gsun16/ECE445/gsun16/all soldered prototype.jpg

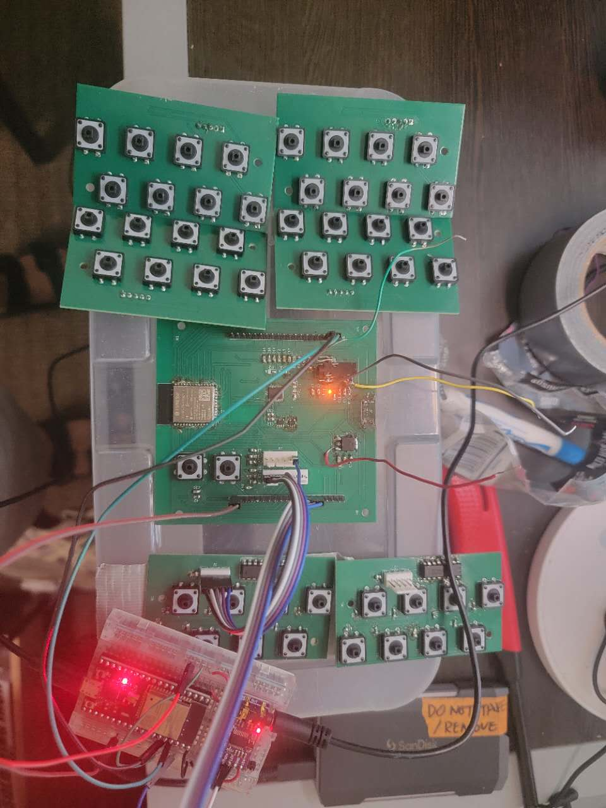
gsun16/all soldered prototype.jpg
