gsun16/ECE445/hanyu and zhuoer/Fig 4.jpg

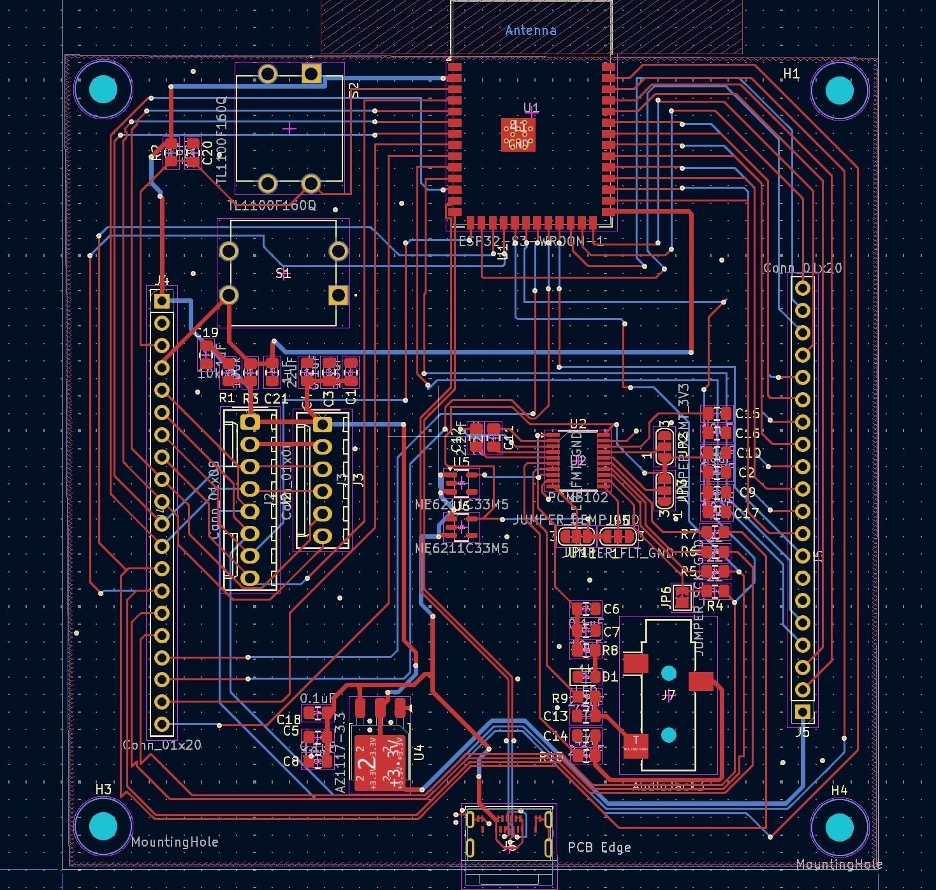
hanyu and zhuoer/Fig 4.jpg
