gsun16/ECE445/README.md

# arduino-accordion

Inspired from the project https://hackaday.io/project/197399-arduino-esp32-standalone-accordion
