gsun16/ECE445/misc/1.pptx

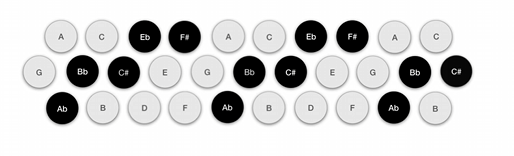
[picture p3: figure]
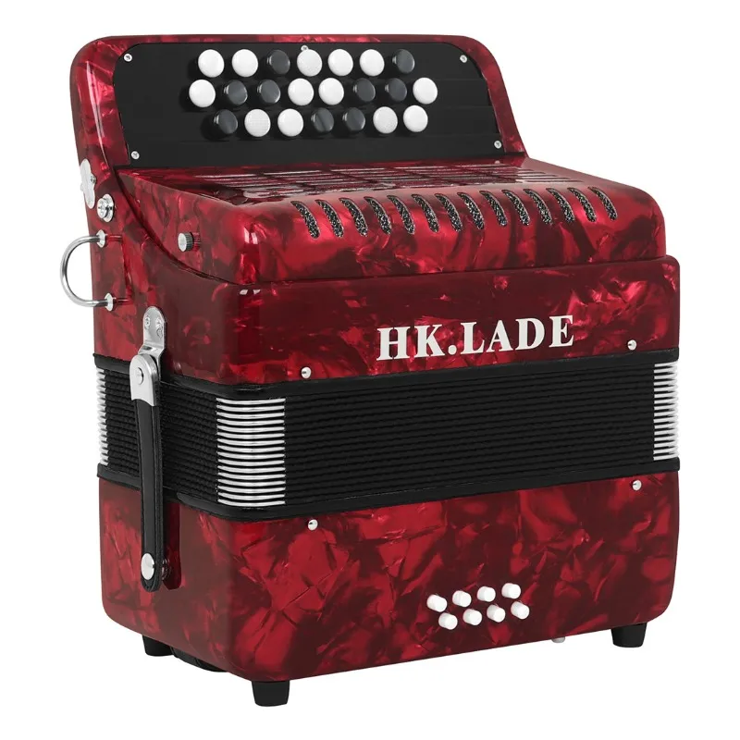
[picture p4: figure]
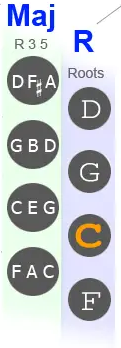
[picture p5: figure]

Treble
Key

All of the electronics will be stored in the bellow of the accordion

Bass
Button
