gsun16/ECE445/gsun16/bass layout.jpg

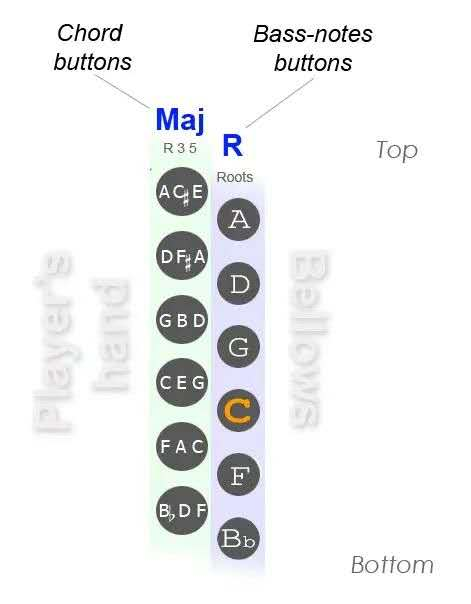
gsun16/bass layout.jpg
