gsun16/ECE445/gsun16/breadboard circuit.jpg

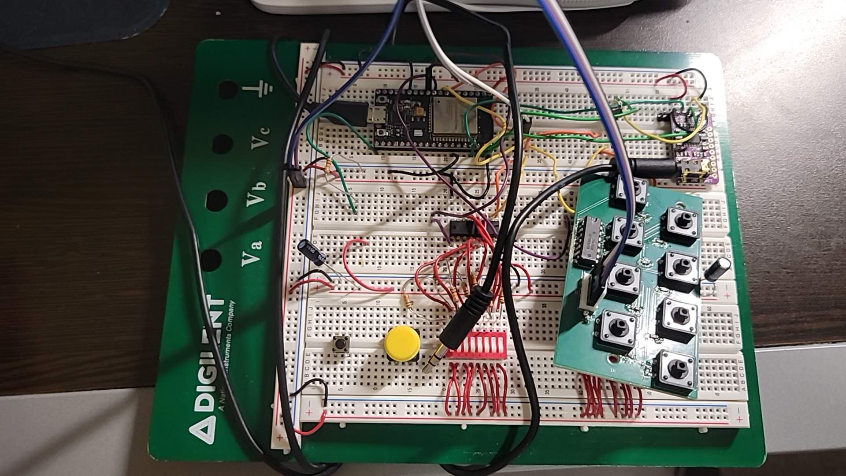
gsun16/breadboard circuit.jpg
