gsun16/ECE445/gsun16/debounce time.png

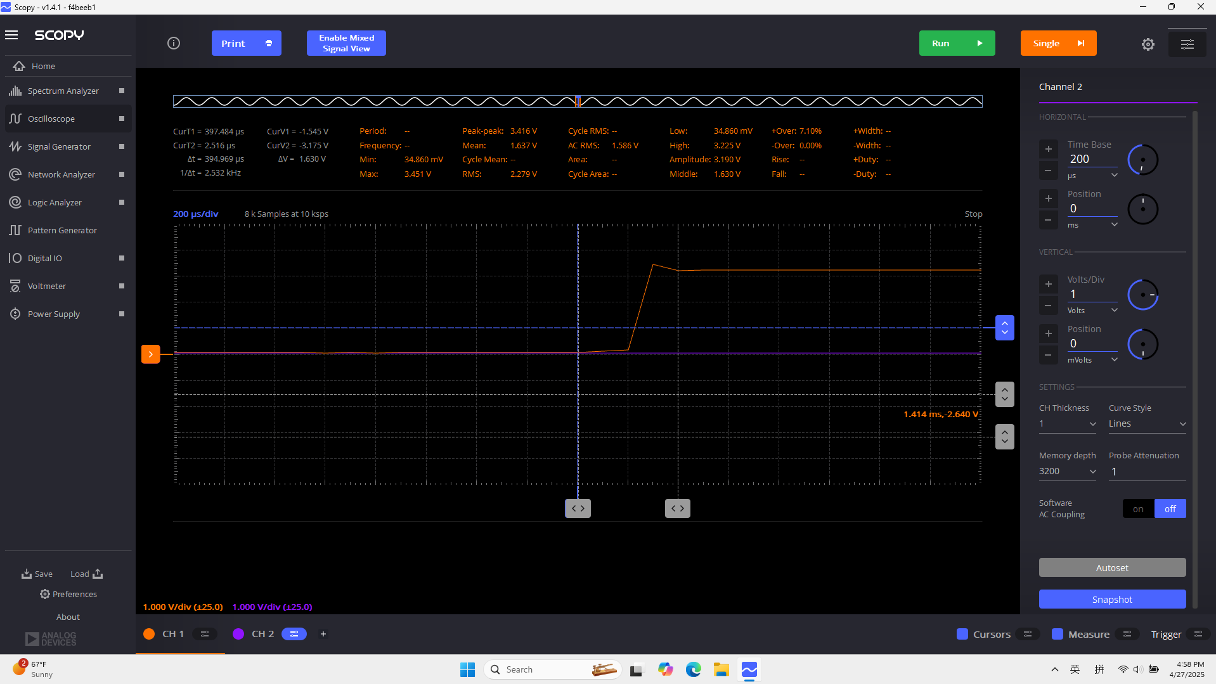
gsun16/debounce time.png
