gsun16/ECE445/gsun16/mapping draft made with hanyu.jpg

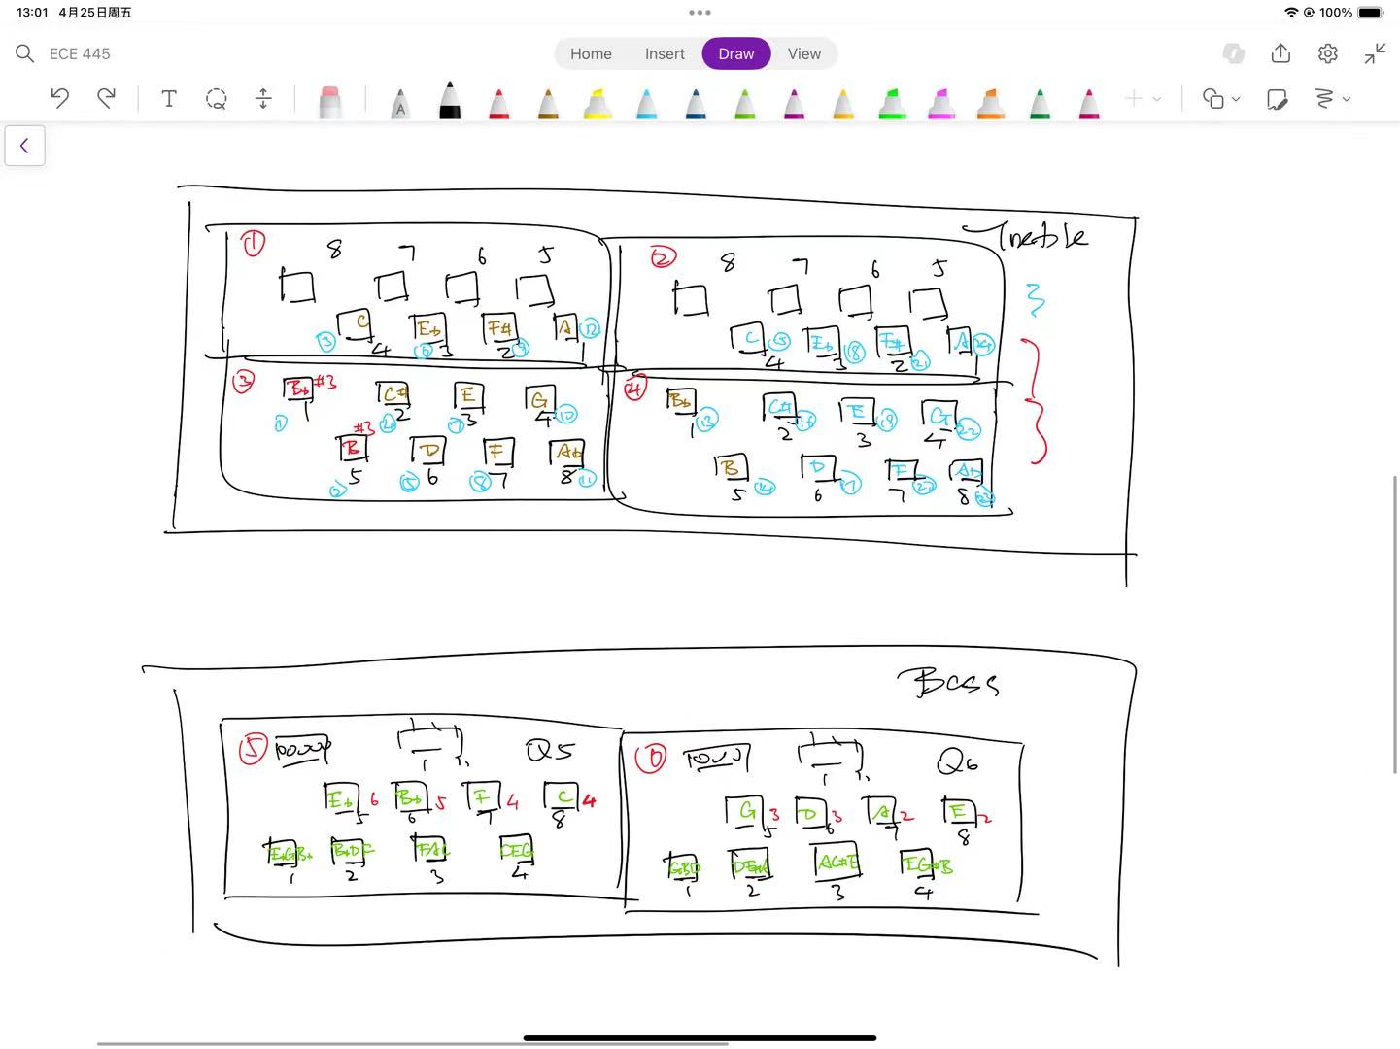
gsun16/mapping draft made with hanyu.jpg
