gsun16/ECE445/hanyu and zhuoer/Fig 1.jpg

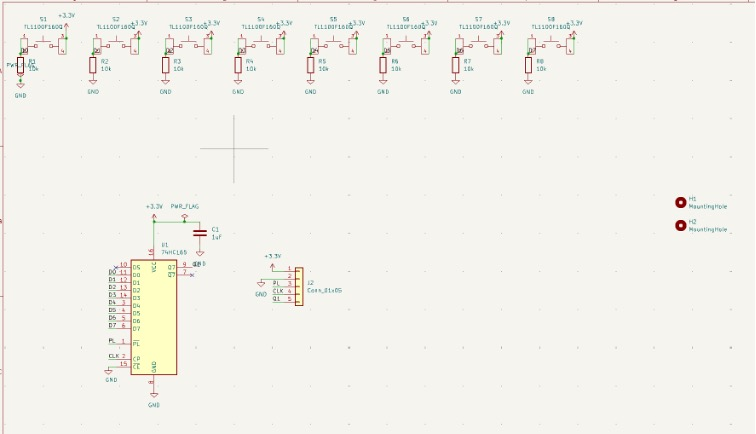
hanyu and zhuoer/Fig 1.jpg
