gsun16/ECE445/hanyu and zhuoer/Fig 2.png

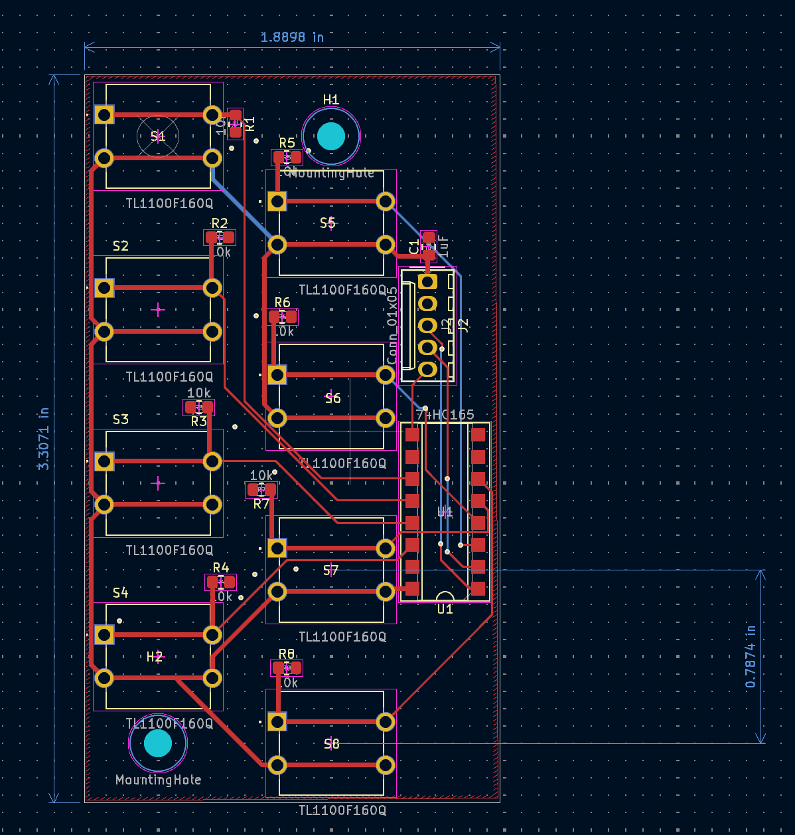
hanyu and zhuoer/Fig 2.png
