gsun16/ECE445/hanyu and zhuoer/Fig 3.jpg

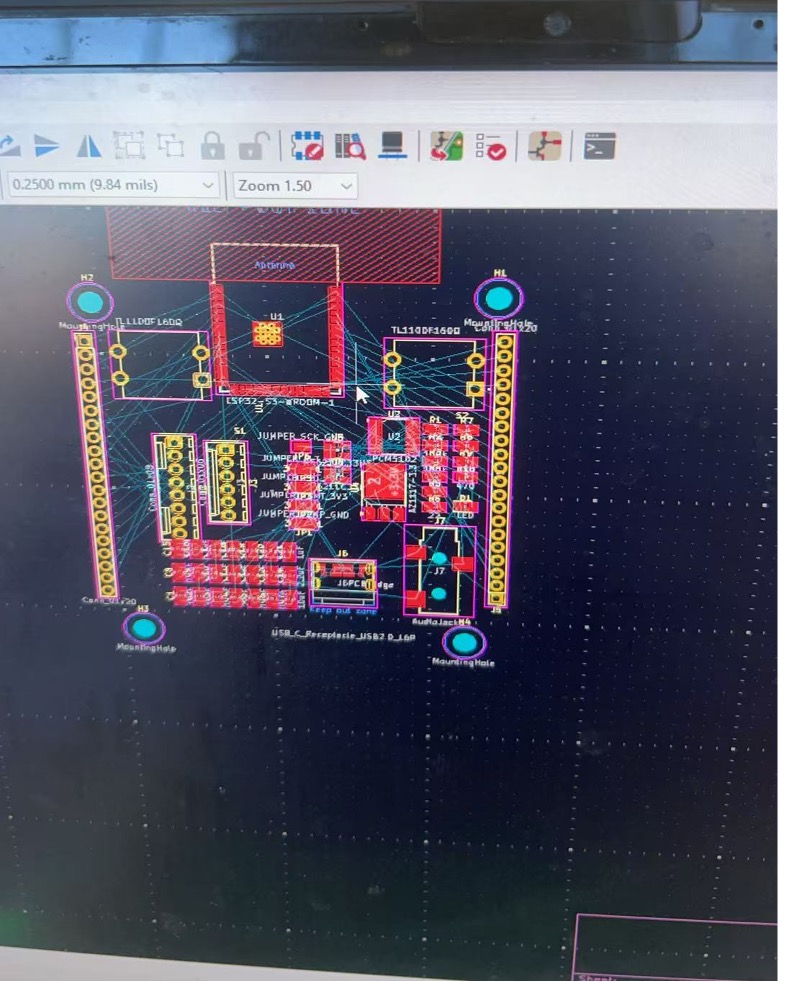
hanyu and zhuoer/Fig 3.jpg
