gsun16/ECE445/hanyu and zhuoer/Fig 5.png

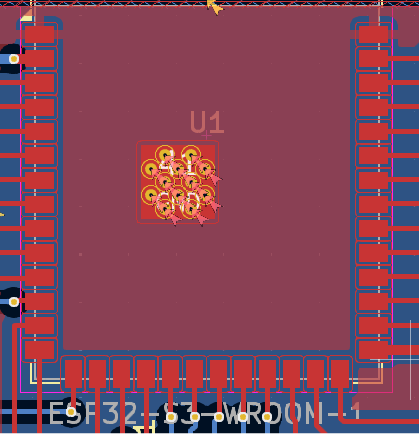
hanyu and zhuoer/Fig 5.png
