gsun16/ECE445/hanyu and zhuoer/Fig 6.jpg

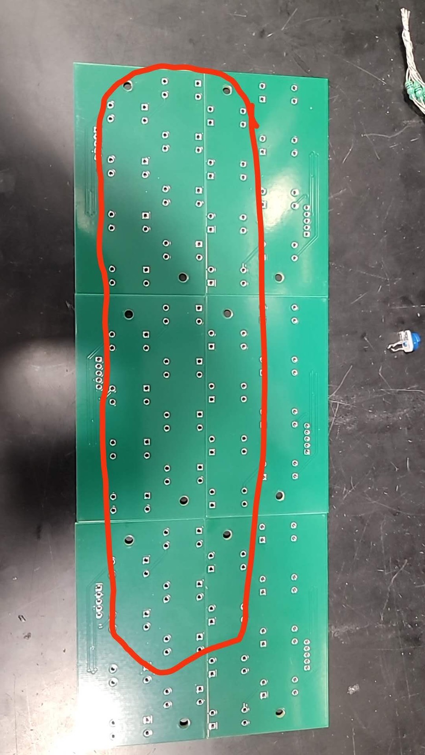
hanyu and zhuoer/Fig 6.jpg
