gsun16/ECE445/hanyu and zhuoer/Fig 7.jpg

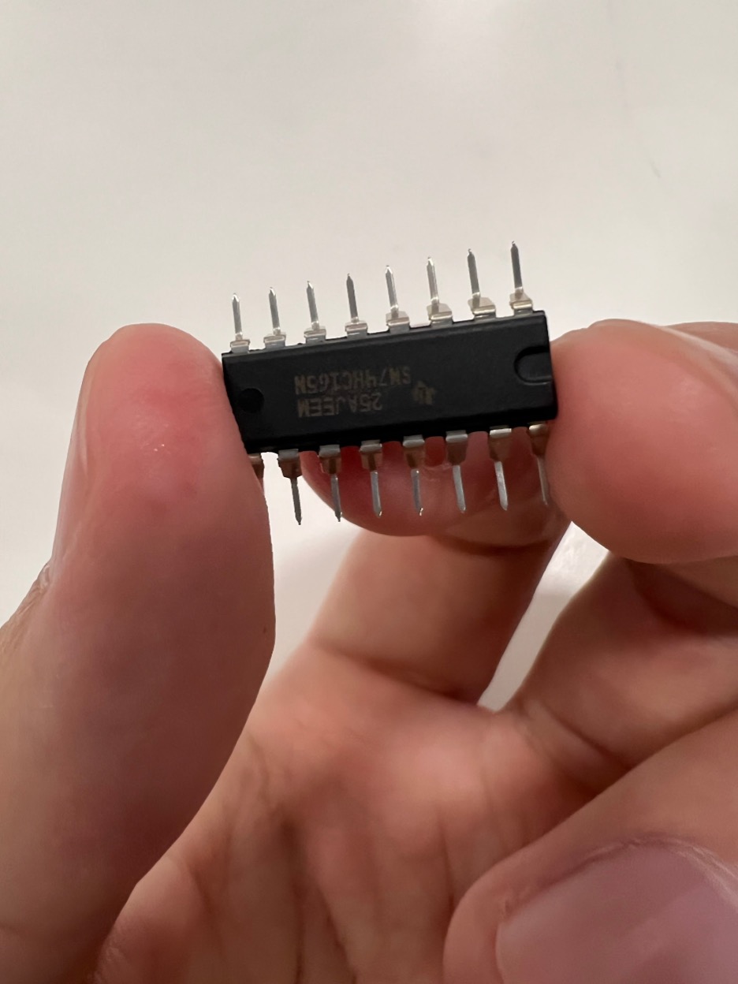
hanyu and zhuoer/Fig 7.jpg
