gsun16/ECE445/hanyu and zhuoer/Fig 8.jpg

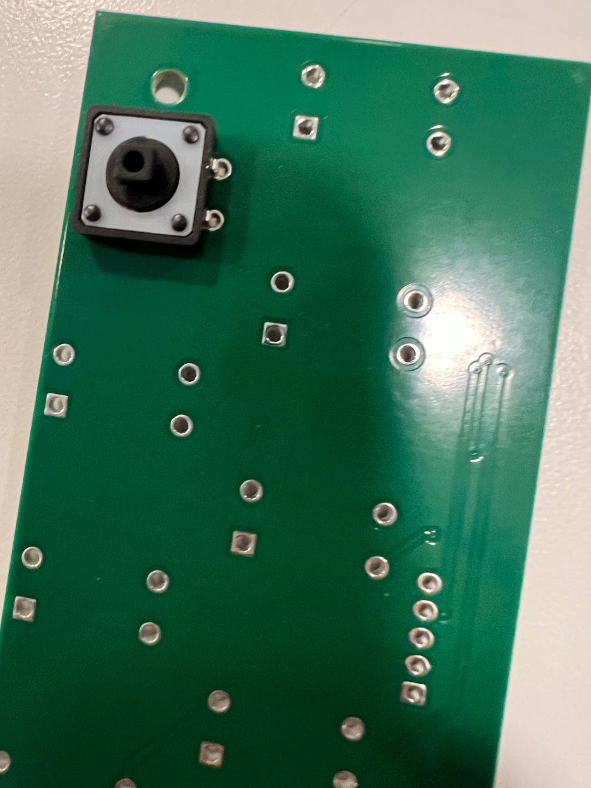
hanyu and zhuoer/Fig 8.jpg
