gsun16/ECE445/hanyu and zhuoer/Fig 9.jpg

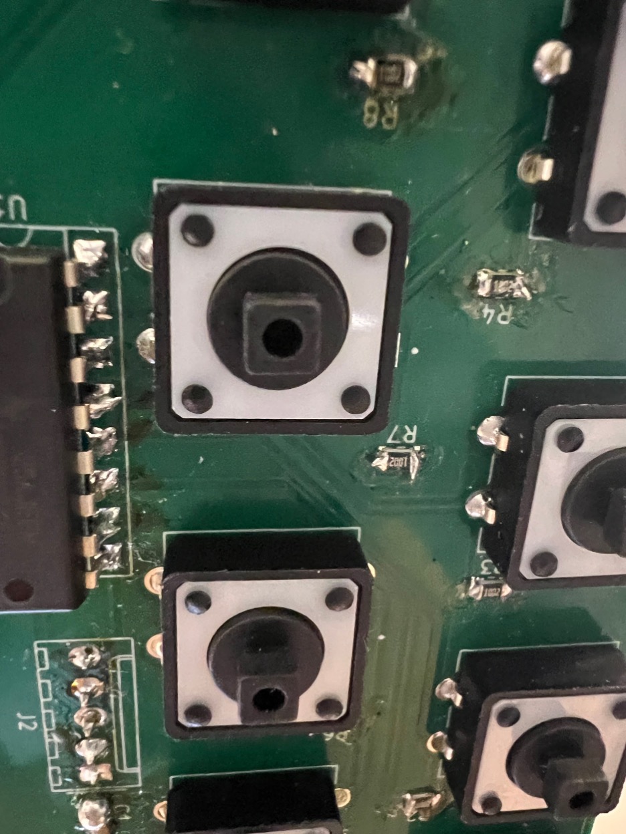
hanyu and zhuoer/Fig 9.jpg
