gsun16/ECE445/hanyu and zhuoer/Fig 11.jpg

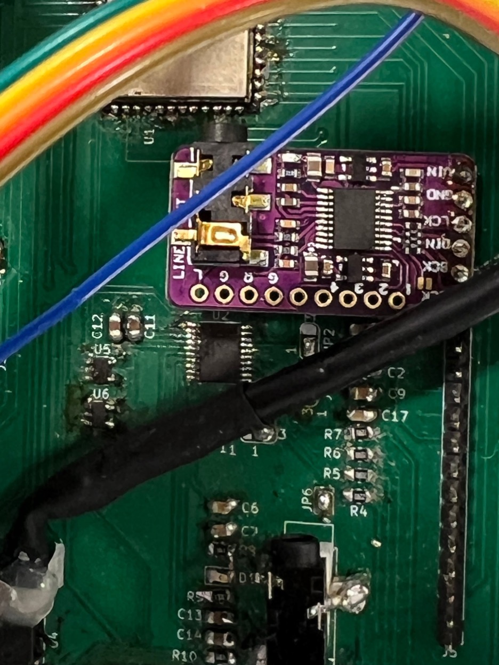
hanyu and zhuoer/Fig 11.jpg
