gsun16/ECE445/hanyu and zhuoer/Fig 12.jpg

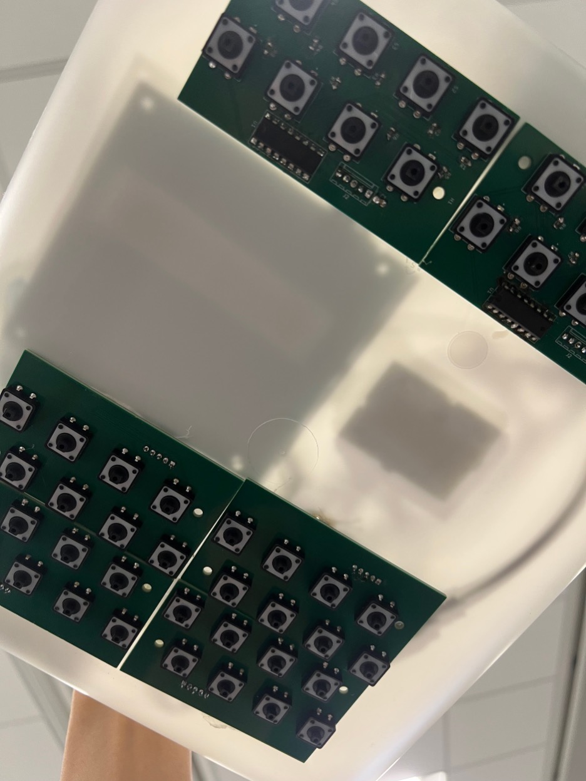
hanyu and zhuoer/Fig 12.jpg
