gsun16/ECE445/hanyu and zhuoer/Fig 13.png

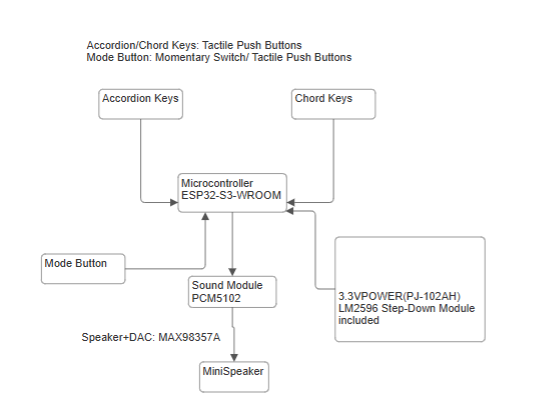
hanyu and zhuoer/Fig 13.png
