gsun16/ECE445/hanyu and zhuoer/Fig 14.png

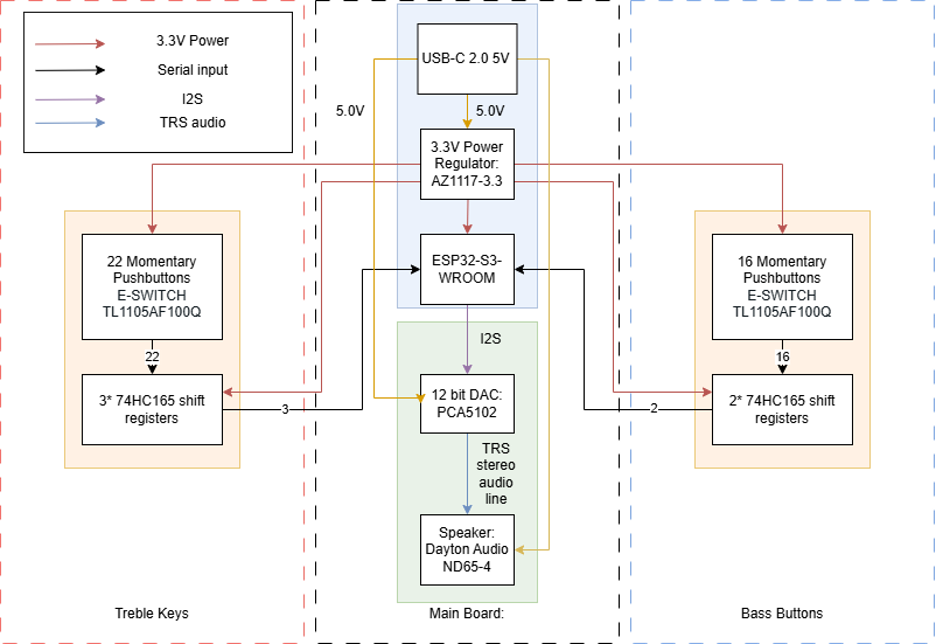
hanyu and zhuoer/Fig 14.png
