gsun16/ECE445/misc/group13_buttons/group13_buttons.kicad_pcb

## KiCad design misc/group13_buttons/group13_buttons.kicad_pcb (2025-04-01)

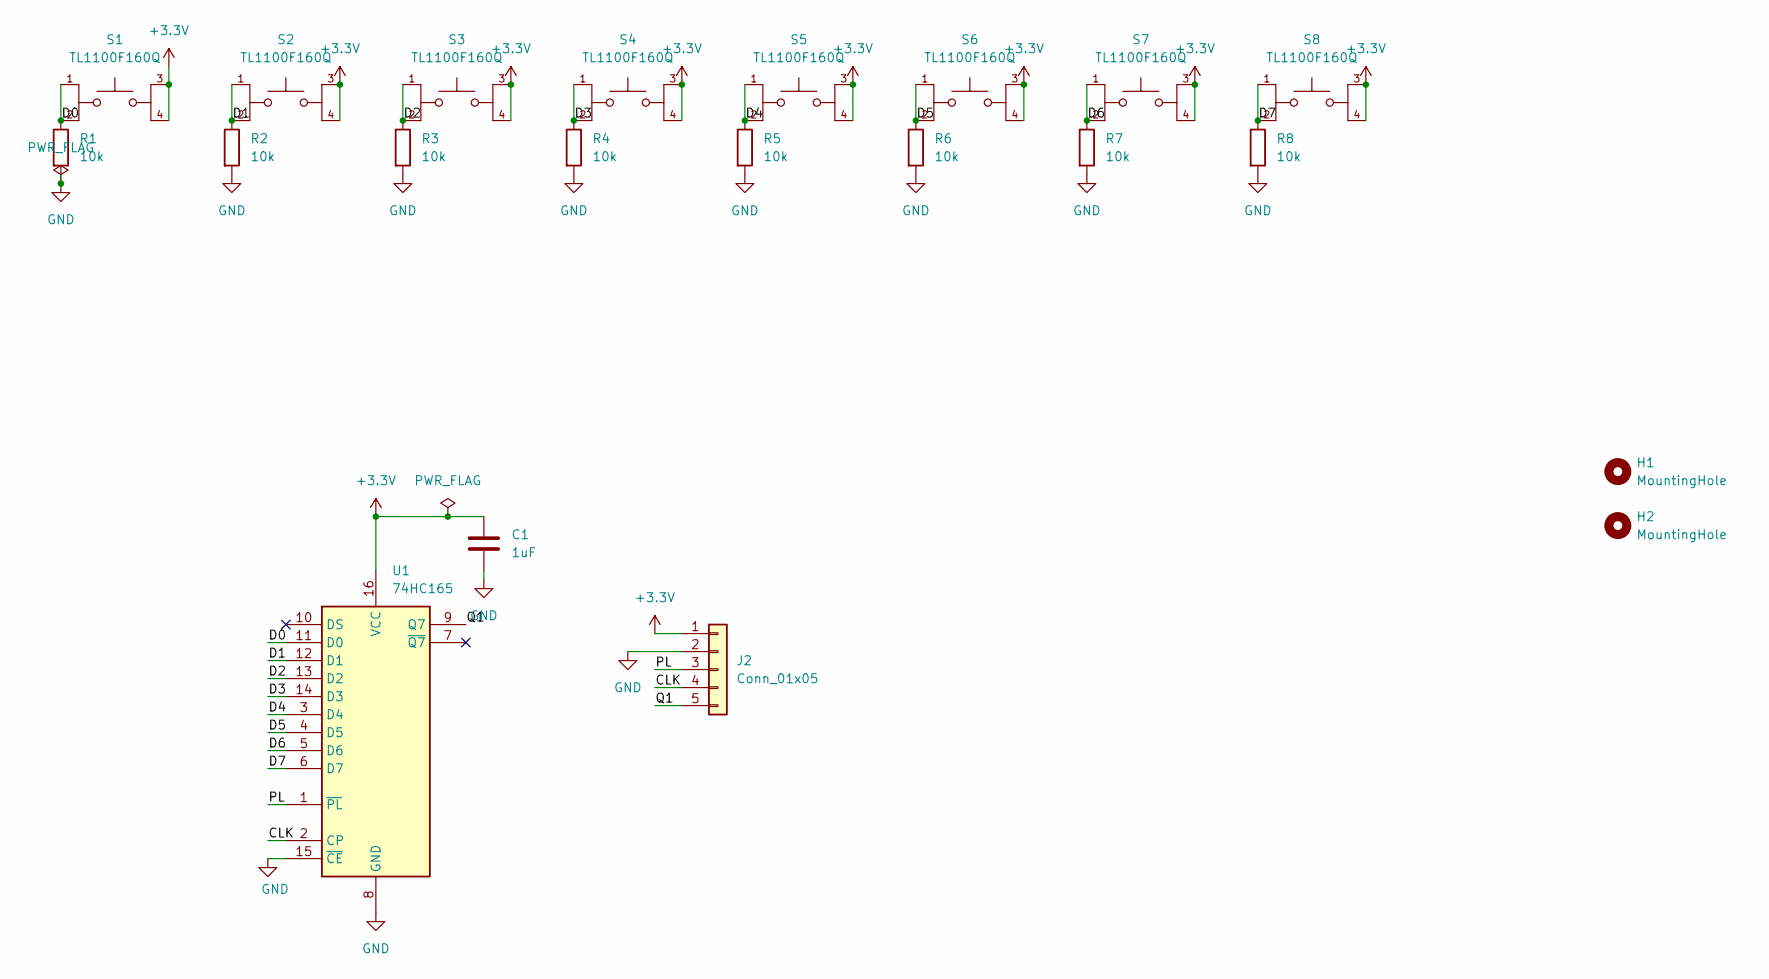
[picture p22: schematic group13_buttons.kicad_sch]

Parts:
C1: 1uF; C_0805_2012Metric_Pad1.18x1.45mm_HandSolder
H1, H2: MountingHole; MountingHole_3.2mm_M3
J2: Conn_01x05; Molex_KK-254_AE-6410-05A_1x05_P2.54mm_Vertical
R1, R2, R3, R4, R5, R6, R7, R8: 10k; R_0805_2012Metric_Pad1.20x1.40mm_HandSolder
S1, S2, S3, S4, S5, S6, S7, S8: TL1100F160Q; SW_TL1100F160Q; PARTREV D
U1: 74HC165; DIP-16_W7.62mm_SMDSocket_SmallPads

Connections:
+3.3V: C1.1, J2.1, S1.3, S1.4, S2.3, S2.4, S3.3, S3.4, S4.3, S4.4, S5.3, S5.4, S6.3, S6.4, S7.3, S7.4, S8.3, S8.4, U1.16 (VCC)
/CLK: J2.4, U1.2 (CP)
/D0: R1.1, S1.1, S1.2, U1.11 (D0)
/D1: R2.1, S2.1, S2.2, U1.12 (D1)
/D2: R3.1, S3.1, S3.2, U1.13 (D2)
/D3: R4.1, S4.1, S4.2, U1.14 (D3)
/D4: R5.1, S5.1, S5.2, U1.3 (D4)
/D5: R6.1, S6.1, S6.2, U1.4 (D5)
/D6: R7.1, S7.1, S7.2, U1.5 (D6)
/D7: R8.1, S8.1, S8.2, U1.6 (D7)
/PL: J2.3, U1.1 (~PL)
/Q1: J2.5, U1.9 (Q7)
GND: C1.2, J2.2, R1.2, R2.2, R3.2, R4.2, R5.2, R6.2, R7.2, R8.2, U1.8 (GND), U1.15 (~CE)

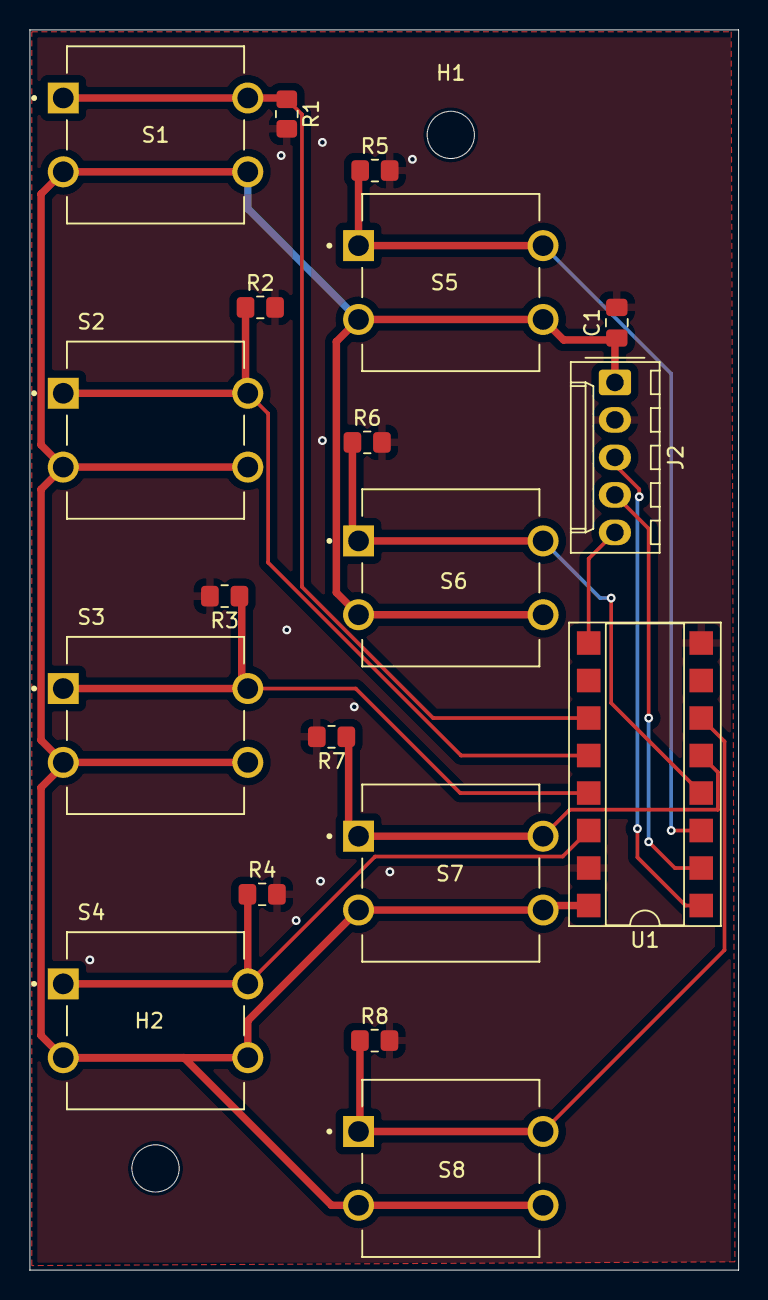
[picture p23: board group13_buttons.kicad_pcb from above]

Board: 2 copper layers, 48.0 x 84.0 mm, 21 parts (0 on the bottom side), 13 nets.
