gsun16/ECE445/misc/group13_esp/group13_esp/group13_esp.kicad_pcb

## KiCad design misc/group13_esp/group13_esp/group13_esp.kicad_pcb (2025-04-01)

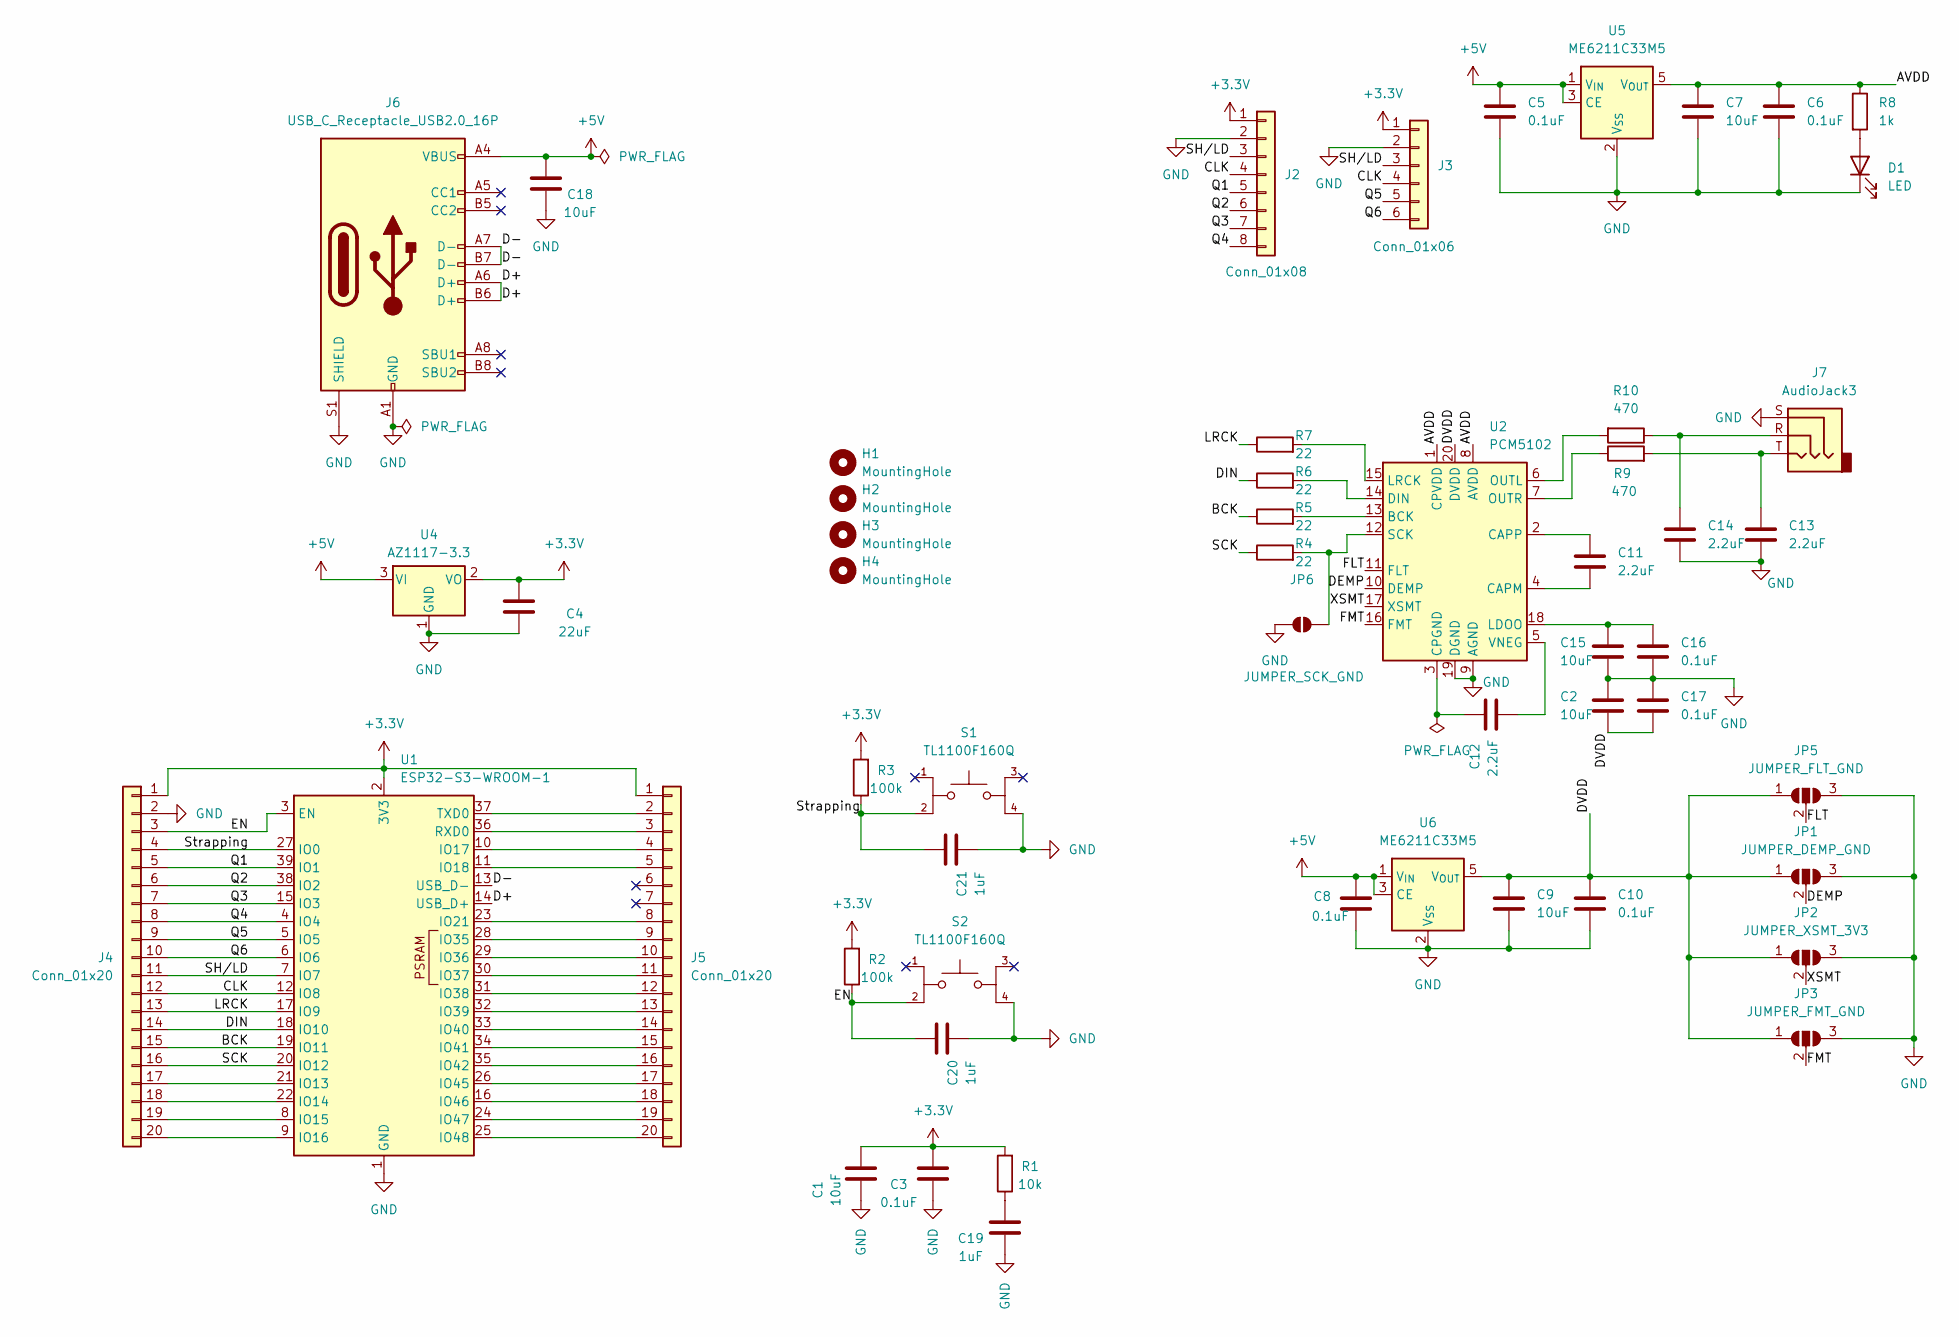
[picture p24: schematic group13_esp.kicad_sch]

Parts:
C1, C2, C7, C9, C15, C18: 10uF; C_0805_2012Metric_Pad1.18x1.45mm_HandSolder
C3, C5, C6, C8, C10, C16, C17: 0.1uF; C_0805_2012Metric_Pad1.18x1.45mm_HandSolder
C4: 22uF; C_0805_2012Metric_Pad1.18x1.45mm_HandSolder
C11, C12, C13, C14: 2.2uF; C_0805_2012Metric_Pad1.18x1.45mm_HandSolder
C19, C20, C21: 1uF; C_0805_2012Metric_Pad1.18x1.45mm_HandSolder
D1: LED; LED_0805_2012Metric_Pad1.15x1.40mm_HandSolder
H1, H2, H3, H4: MountingHole; MountingHole_3.2mm_M3
J2: Conn_01x08; Molex_KK-254_AE-6410-08A_1x08_P2.54mm_Vertical
J3: Conn_01x06; Molex_KK-254_AE-6410-06A_1x06_P2.54mm_Vertical
J4, J5: Conn_01x20; PinHeader_1x20_P2.54mm_Vertical
J6: USB_C_Receptacle_USB2.0_16P; USB_C_Receptacle_Amphenol_124019772112A
J7: AudioJack3; Jack_3.5mm_CUI_SJ-3523-SMT_Horizontal
JP1: JUMPER_DEMP_GND; SolderJumper-3_P1.3mm_Open_RoundedPad1.0x1.5mm_NumberLabels
JP2: JUMPER_XSMT_3V3; SolderJumper-3_P1.3mm_Open_RoundedPad1.0x1.5mm_NumberLabels
JP3: JUMPER_FMT_GND; SolderJumper-3_P1.3mm_Open_RoundedPad1.0x1.5mm_NumberLabels
JP5: JUMPER_FLT_GND; SolderJumper-3_P1.3mm_Open_RoundedPad1.0x1.5mm_NumberLabels
JP6: JUMPER_SCK_GND; SolderJumper-2_P1.3mm_Open_TrianglePad1.0x1.5mm
R1: 10k; R_0805_2012Metric_Pad1.20x1.40mm_HandSolder
R2, R3: 100k; R_0805_2012Metric_Pad1.20x1.40mm_HandSolder
R4, R5, R6, R7: 22; R_0805_2012Metric_Pad1.20x1.40mm_HandSolder
R8: 1k; R_0805_2012Metric_Pad1.20x1.40mm_HandSolder
R9, R10: 470; R_0805_2012Metric_Pad1.20x1.40mm_HandSolder
S1, S2: TL1100F160Q; SW_TL1100F160Q; PARTREV D
U1: ESP32-S3-WROOM-1
U2: PCM5102; TSSOP-20_4.4x6.5mm_P0.65mm
U4: AZ1117-3.3; TO-252-3_TabPin2
U5, U6: ME6211C33M5; SOT-23-5

Connections:
+3.3V: C1.2, C3.2, C4.2, J2.1, J3.1, J4.1, J5.1, R1.2, R2.2, R3.2, U1.2 (3V3), U4.2 (VO)
+5V: C5.1, C8.1, C18.2, J6.A4 (VBUS), J6.A9 (VBUS), J6.B4 (VBUS), J6.B9 (VBUS), U4.3 (VI), U5.1 (V_{IN}), U5.3 (CE), U6.1 (V_{IN}), U6.3 (CE)
/AVDD: C6.1, C7.1, R8.1, U2.1 (CPVDD), U2.8 (AVDD), U5.5 (V_{OUT})
/BCK: J4.15, R5.1, U1.19 (IO11)
/CLK: J2.4, J3.4, J4.12, U1.12 (IO8)
/D+: J6.A6 (D+), J6.B6 (D+), U1.14 (USB_D+)
/D-: J6.A7 (D-), J6.B7 (D-), U1.13 (USB_D-)
/DEMP: JP1.2 (C), U2.10 (DEMP)
/DIN: J4.14, R6.1, U1.18 (IO10)
/DVDD: C2.2, C9.1, C10.1, C17.2, JP1.1 (A), JP2.1 (A), JP3.1 (A), JP5.1 (A), U2.20 (DVDD), U6.5 (V_{OUT})
/EN: C20.2, J4.3, R2.1, S2.2, U1.3 (EN)
/FLT: JP5.2 (C), U2.11 (FLT)
/FMT: JP3.2 (C), U2.16 (FMT)
/LRCK: J4.13, R7.1, U1.17 (IO9)
/Q1: J2.5, J4.5, U1.39 (IO1)
/Q2: J2.6, J4.6, U1.38 (IO2)
/Q3: J2.7, J4.7, U1.15 (IO3)
/Q4: J2.8, J4.8, U1.4 (IO4)
/Q5: J3.5, J4.9, U1.5 (IO5)
/Q6: J3.6, J4.10, U1.6 (IO6)
/SCK: J4.16, R4.1, U1.20 (IO12)
/SH/LD: J2.3, J3.3, J4.11, U1.7 (IO7)
/Strapping: C21.2, J4.4, R3.1, S1.2, U1.27 (IO0)
/XSMT: JP2.2 (C), U2.17 (XSMT)
GND: C1.1, C2.1, C3.1, C4.1, C5.2, C6.2, C7.2, C8.2, C9.2, C10.2, C13.2, C14.1, C15.2, C16.2, C17.1, C18.1, C19.1, C20.1, C21.1, D1.1 (K), J2.2, J3.2, J4.2, J6.A1 (GND), J6.A12 (GND), J6.B1 (GND), J6.B12 (GND), J6.S1 (SHIELD), J7.S, JP1.3 (B), JP2.3 (B), JP3.3 (B), JP5.3 (B), JP6.1 (A), S1.4, S2.4, U1.1 (GND), U1.40 (GND), U1.41 (GND), U2.9 (AGND), U2.19 (DGND), U4.1 (GND), U5.2 (V_{SS}), U6.2 (V_{SS})
unnamed: C13.1, J7.T, R9.2
unnamed: C14.2, J7.R, R10.1
unnamed: C19.2, R1.1
unnamed: D1.2 (A), R8.2
unnamed: J4.17, U1.21 (IO13)
unnamed: J4.18, U1.22 (IO14)
unnamed: J4.19, U1.8 (IO15)
unnamed: J4.20, U1.9 (IO16)
unnamed: J5.2, U1.37 (TXD0)
unnamed: J5.3, U1.36 (RXD0)
unnamed: J5.4, U1.10 (IO17)
unnamed: J5.5, U1.11 (IO18)
unnamed: J5.8, U1.23 (IO21)
unnamed: J5.9, U1.28 (IO35)
unnamed: J5.10, U1.29 (IO36)
unnamed: J5.11, U1.30 (IO37)
unnamed: J5.12, U1.31 (IO38)
unnamed: J5.13, U1.32 (IO39)
unnamed: J5.14, U1.33 (IO40)
unnamed: J5.15, U1.34 (IO41)
unnamed: J5.16, U1.35 (IO42)
unnamed: J5.17, U1.26 (IO45)
unnamed: J5.18, U1.16 (IO46)
unnamed: J5.19, U1.24 (IO47)
unnamed: J5.20, U1.25 (IO48)
unnamed: JP6.2 (B), R4.2, U2.12 (SCK)
unnamed: R5.2, U2.13 (BCK)
unnamed: C11.2, U2.4 (CAPM)
unnamed: C11.1, U2.2 (CAPP)
unnamed: C12.1, U2.3 (CPGND)
unnamed: R6.2, U2.14 (DIN)
unnamed: C15.1, C16.1, U2.18 (LDOO)
unnamed: R7.2, U2.15 (LRCK)
unnamed: R10.2, U2.6 (OUTL)
unnamed: R9.1, U2.7 (OUTR)
unnamed: C12.2, U2.5 (VNEG)

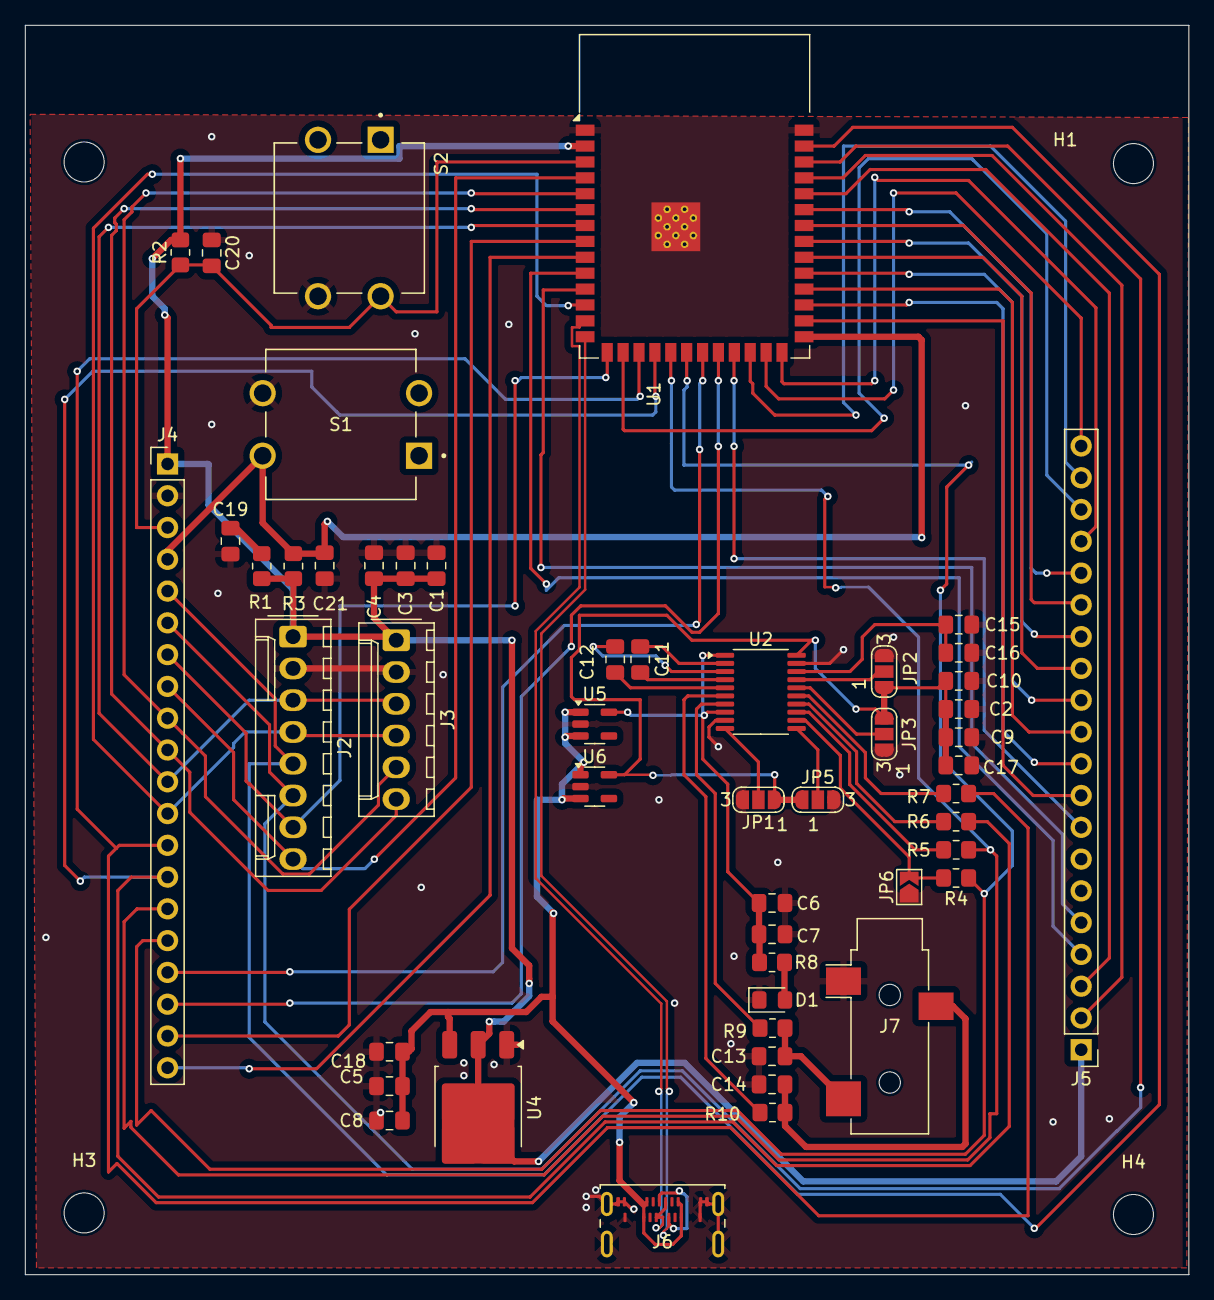
[picture p25: board group13_esp.kicad_pcb from above]

Board: 2 copper layers, 93.0 x 99.9 mm, 54 parts (0 on the bottom side), 61 nets.
