gsun16/ECE445/code/src/ShiftRegisterInKeyboard.h

#ifndef KEYBOARD_H
#define KEYBOARD_H

#include <Arduino.h>

// Define pins for 74HC165 shift register


/*
//dev
const int DATA_PIN = 27;
const int DATA_PIN2 = 26;
const int CLOCK_PIN = 25;
const int LOAD_PIN = 33;
*/
//s3
const int DATA_PINS[6] = {1, 2, 3, 4, 5, 6};
const int CLOCK_PIN = 8;
const int LOAD_PIN = 7;


const int NUM_KEYS = 48;

class ShiftRegisterInKeyboard {
public:
    ShiftRegisterInKeyboard();
    void begin();
    void update();
    void onKeyPress(void (*callback)(int key));
    void onKeyRelease(void (*callback)(int key));
private:
    void (*keyPressCallback)(int key);
    void (*keyReleaseCallback)(int key);
};

#endif
