gsun16/ECE445/(commit log)

2025-04-01 add pcbs
    [group13_buttons-B_Cu.gbr, group13_buttons-B_Mask.gbr, group13_buttons-B_Paste.gbr, group13_buttons-B_Silkscreen.gbr, group13_buttons-Edge_Cuts.gbr, group13_buttons-F_Cu.gbr, group13_buttons-F_Mask.gbr, group13_buttons-F_Paste.gbr]
2025-04-27 chords working, reduce button read time
2025-04-28 increase sample rate
